ryantcliff/AutomaticDoorLock/ProjectPictures/BuildProcess.jpeg

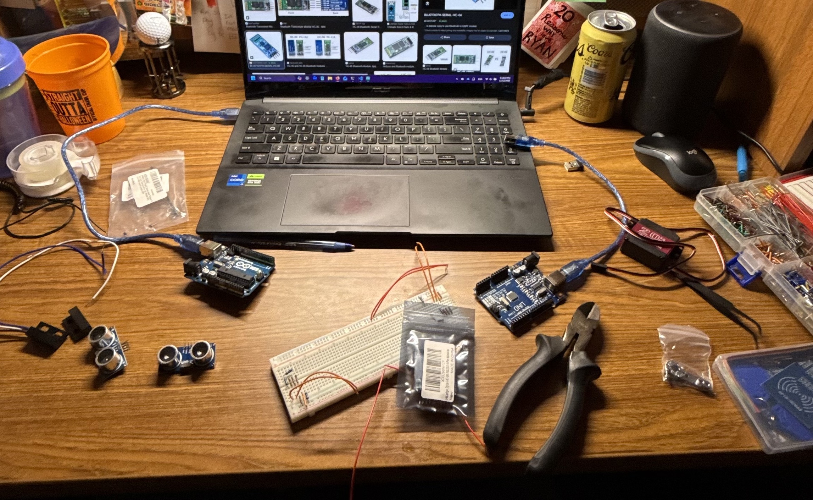
ProjectPictures/BuildProcess.jpeg
