ryantcliff/AutomaticDoorLock/ProjectPictures/OutsideControllerUnit.jpeg

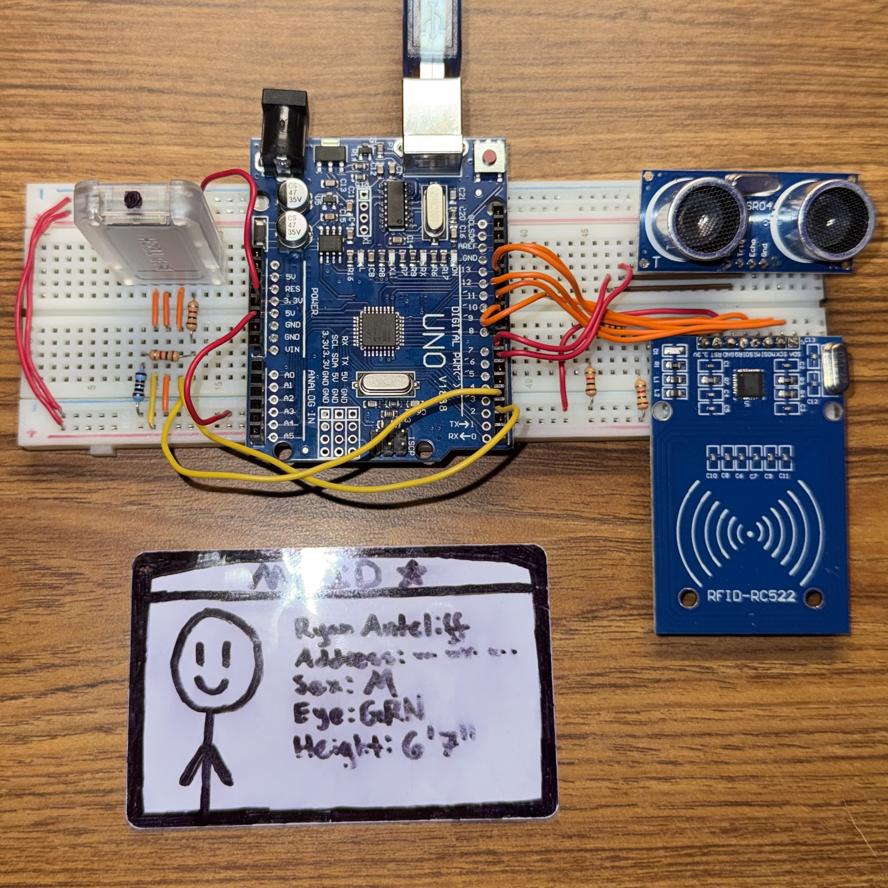
ProjectPictures/OutsideControllerUnit.jpeg
