ryantcliff/AutomaticDoorLock/Phases/Phase1.pdf

Ryan Antcliff
Dr. Mohammed
CSE 321
30 September 2025

## Phase 1: Smart Automatic Door Lock

It is a reoccurring issue that when I leave my apartment in the morning, I forget to lock the front door. Additionally, sometimes I forget my keys and become locked out when my roommates lock the door. A solution to this I wish to propose is an automatic locking device that can be attached to a standard Hadley Village apartment door lock that is able to take care of locking and unlocking the door on its own. The device must be able to sense that it’s closed to initiate itself to lock the door. It must also be able to sense a person approaching the door from inside the apartment to unlock it. On the exterior of the door, it needs to be able to detect a person approaching, like the way it does on the inside, but additionally, it would require a camera and facial recognition technology to unlock the door for only authorized persons that wish to enter.

## UML Case Diagram

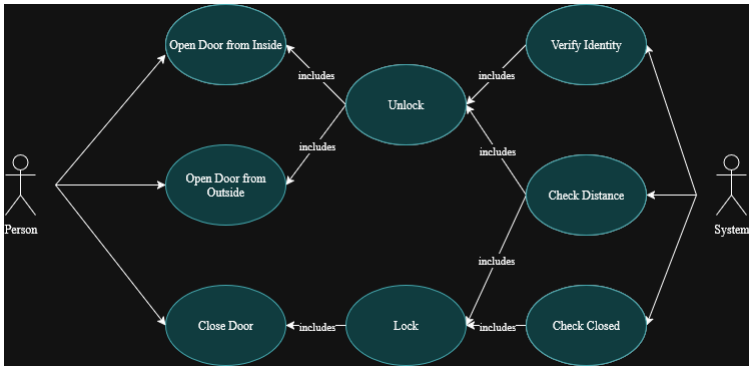
[picture p7: figure]

## CRC Cards

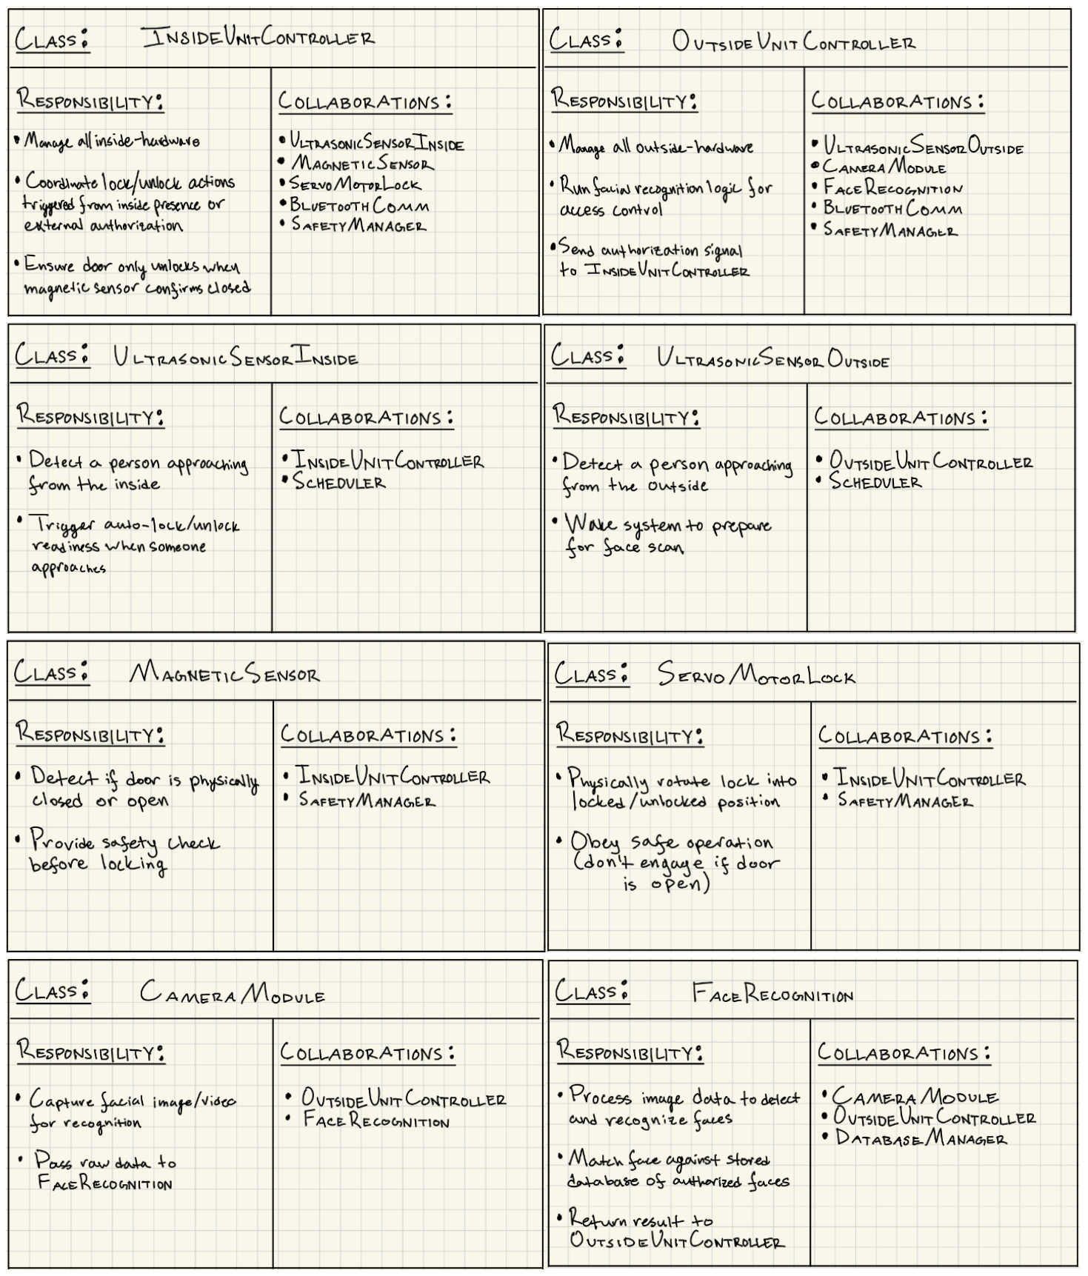
[picture p8: figure]

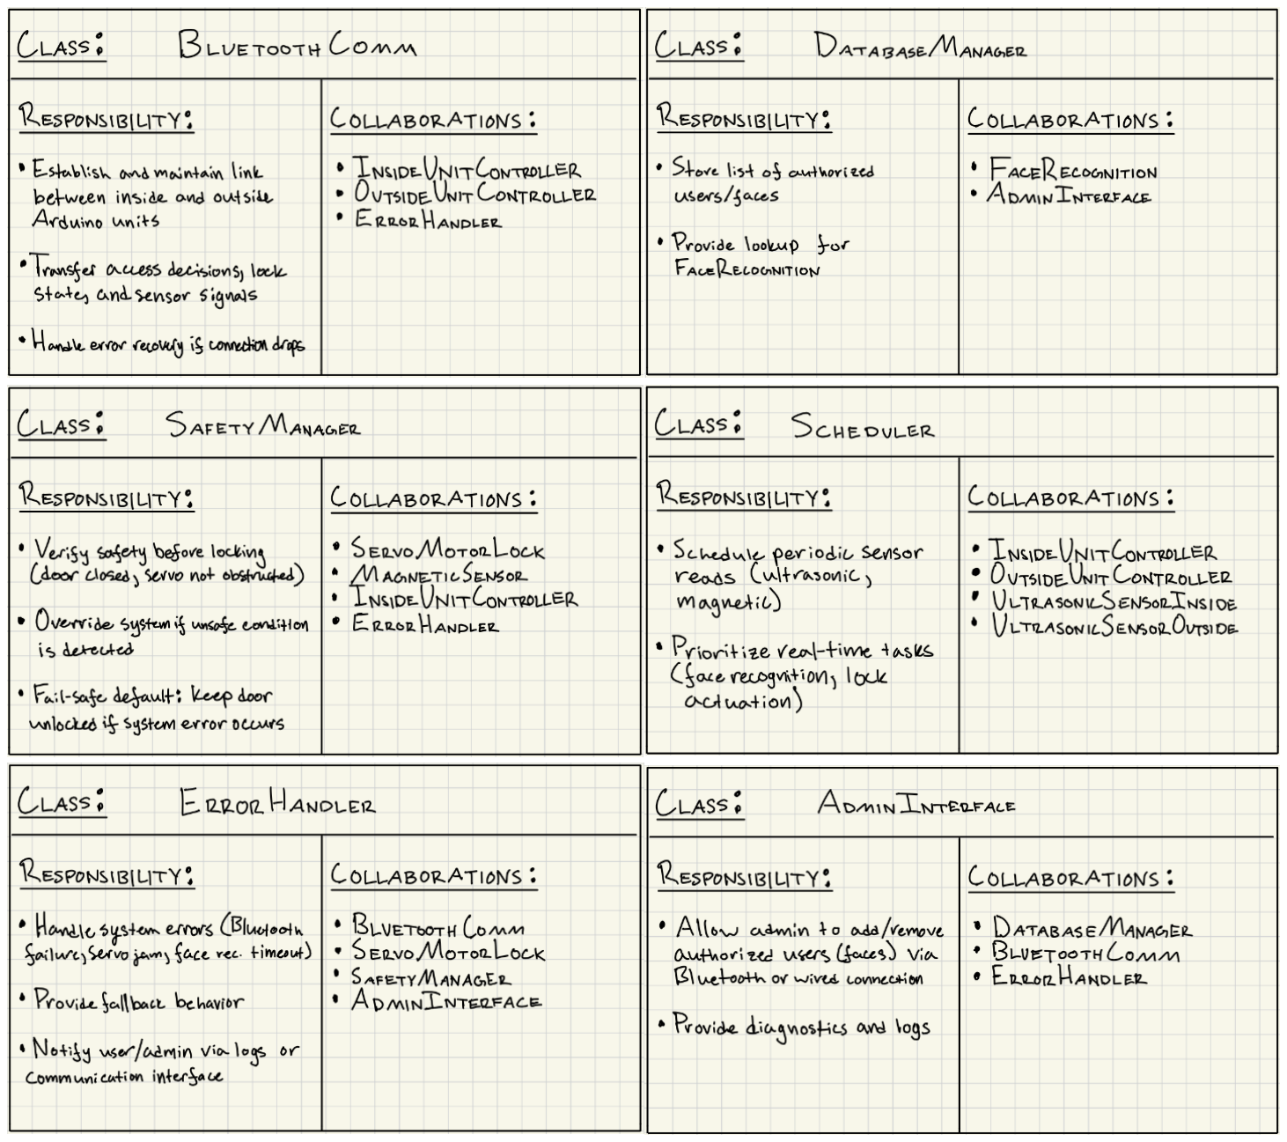
[picture p9: figure]

## Architectural Block Diagram

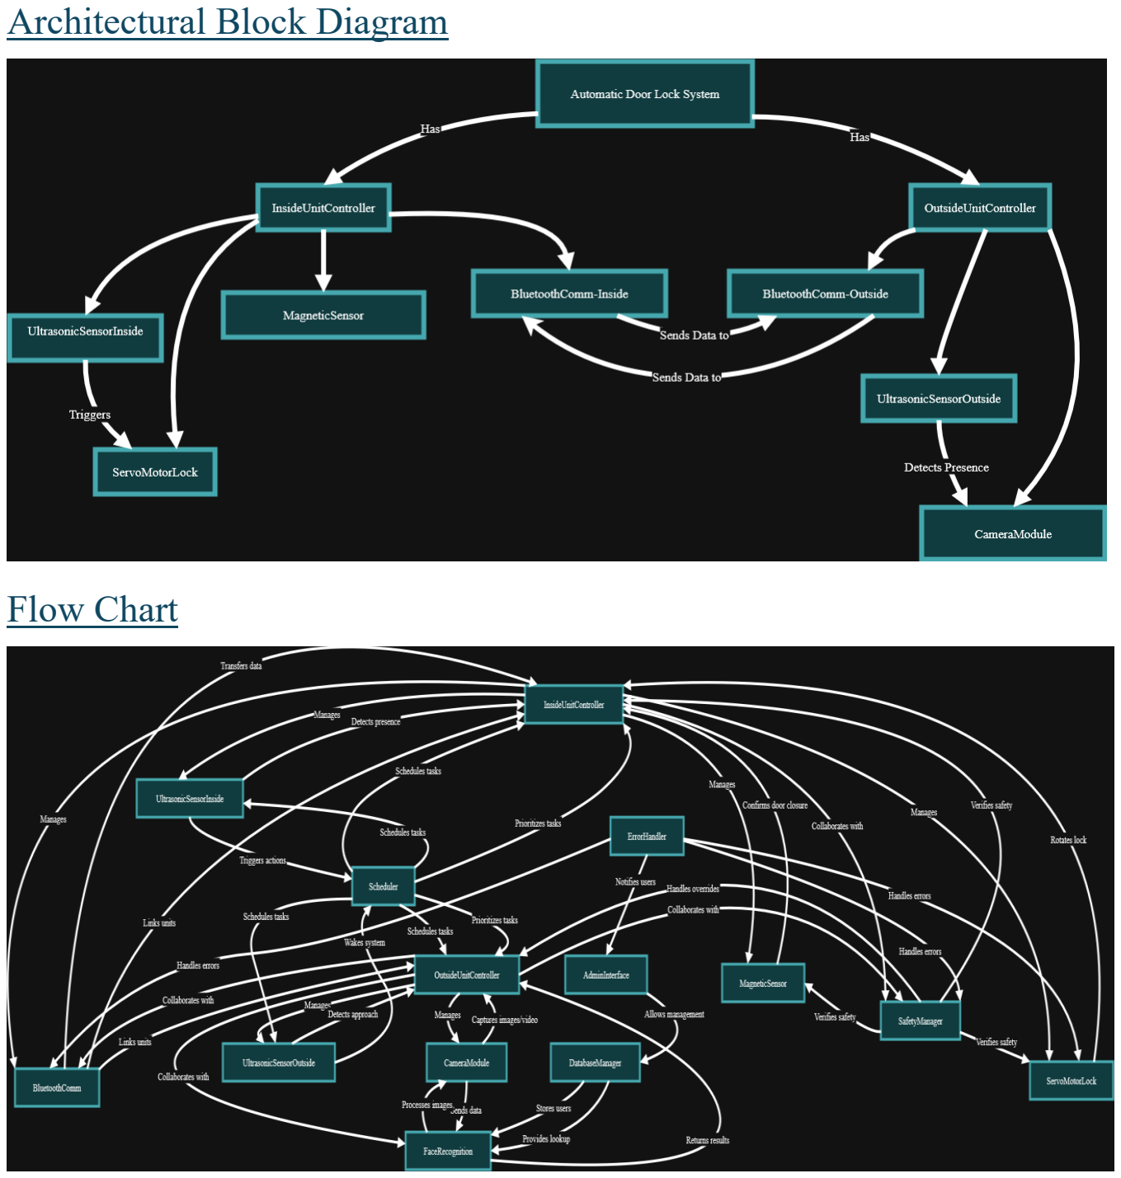
[picture p10: page 4]

## Flow Chart

## Component List

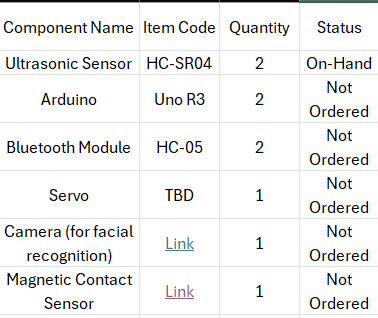
[picture p11: figure]
