ryantcliff/AutomaticDoorLock/(commit log)

2025-12-05 Revise wiring diagrams and HC-05 configuration steps
    Updated wiring diagrams and corrected HC-05 role and cmode settings.
2025-12-07 Replace wiring diagrams in README
    Updated wiring diagrams for Inside and Outside Controller Units.
